nahu02/PhysicalComputing-MainAssignment/Final_Report/figure/agent_pcb_bottom_fusion.png

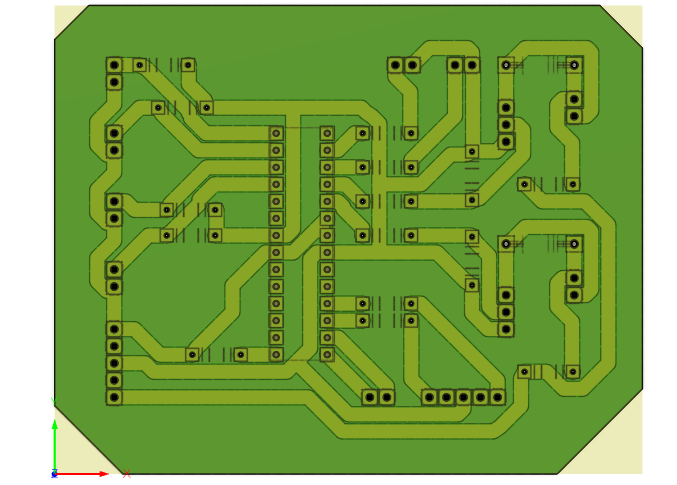
Final_Report/figure/agent_pcb_bottom_fusion.png
