nahu02/PhysicalComputing-MainAssignment/Final_Report/figure/buzzer_mount_angle.jpg

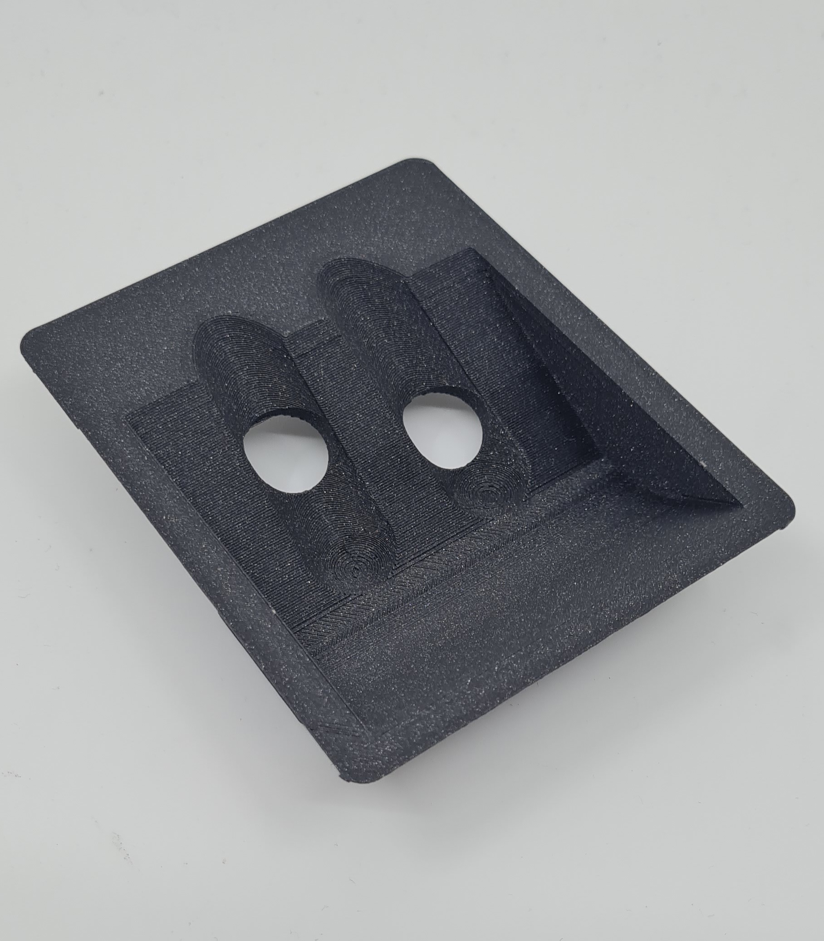
Final_Report/figure/buzzer_mount_angle.jpg
