nahu02/PhysicalComputing-MainAssignment/Final_Report/figure/controller_pcb_bottom_fusion.png

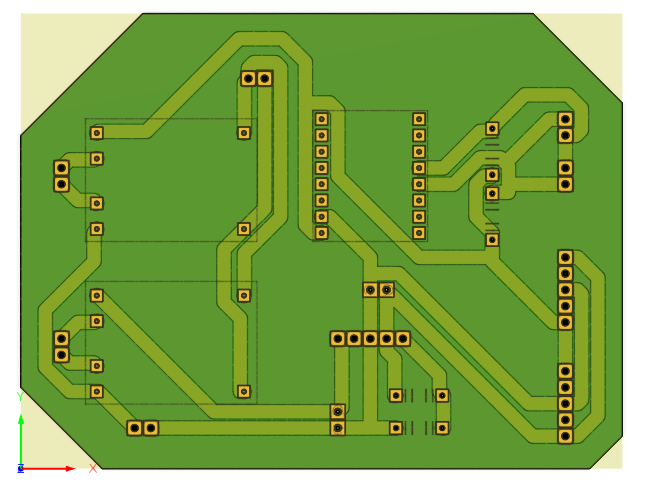
Final_Report/figure/controller_pcb_bottom_fusion.png
