nahu02/PhysicalComputing-MainAssignment/Final_Report/figure/led_keycap_side_v1.jpg

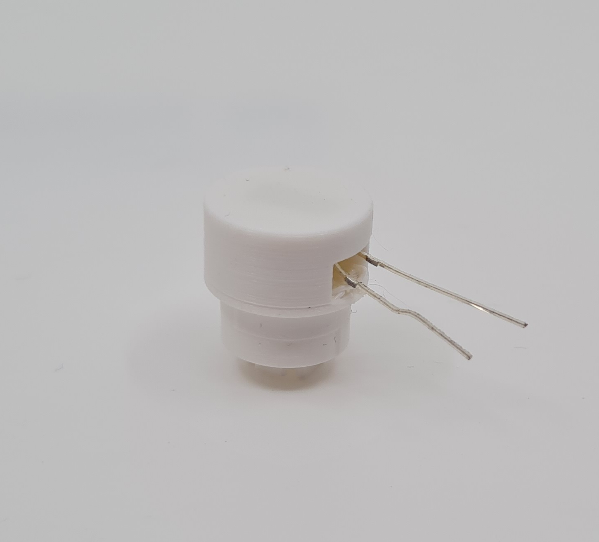
Final_Report/figure/led_keycap_side_v1.jpg
