nahu02/PhysicalComputing-MainAssignment/Final_Report/figure/led_keycap_top_v1.jpg

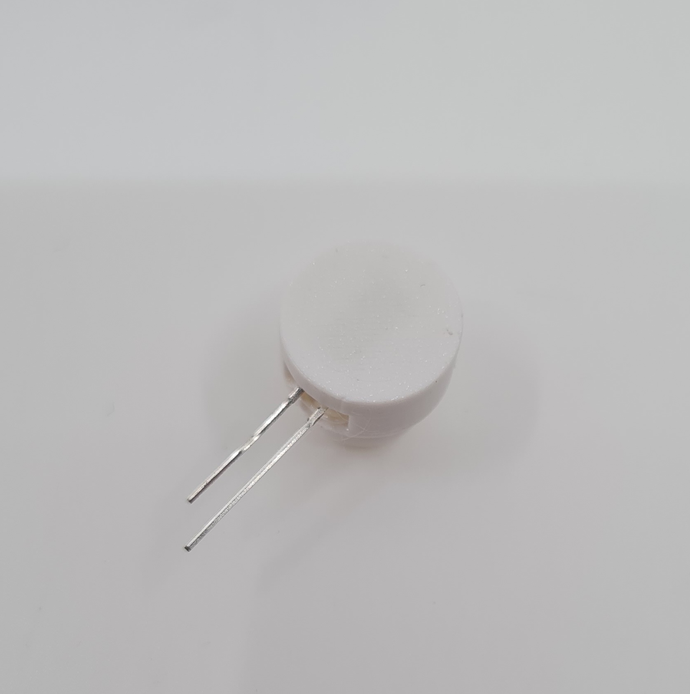
Final_Report/figure/led_keycap_top_v1.jpg
