nahu02/PhysicalComputing-MainAssignment/Final_Report/figure/led_mount_angle.jpg

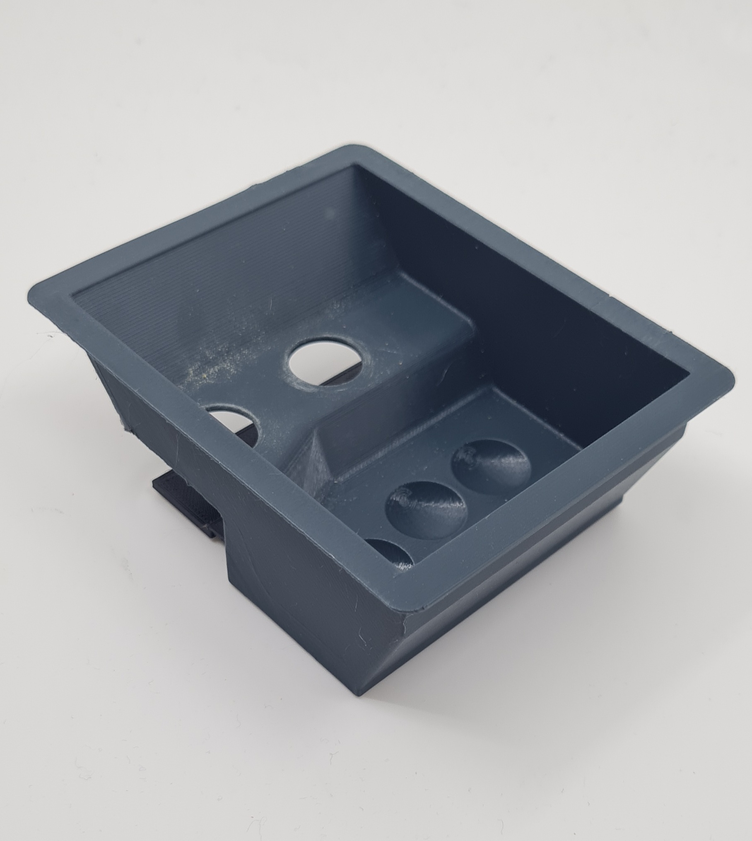
Final_Report/figure/led_mount_angle.jpg
