nahu02/PhysicalComputing-MainAssignment/Final_Report/figure/sample.png

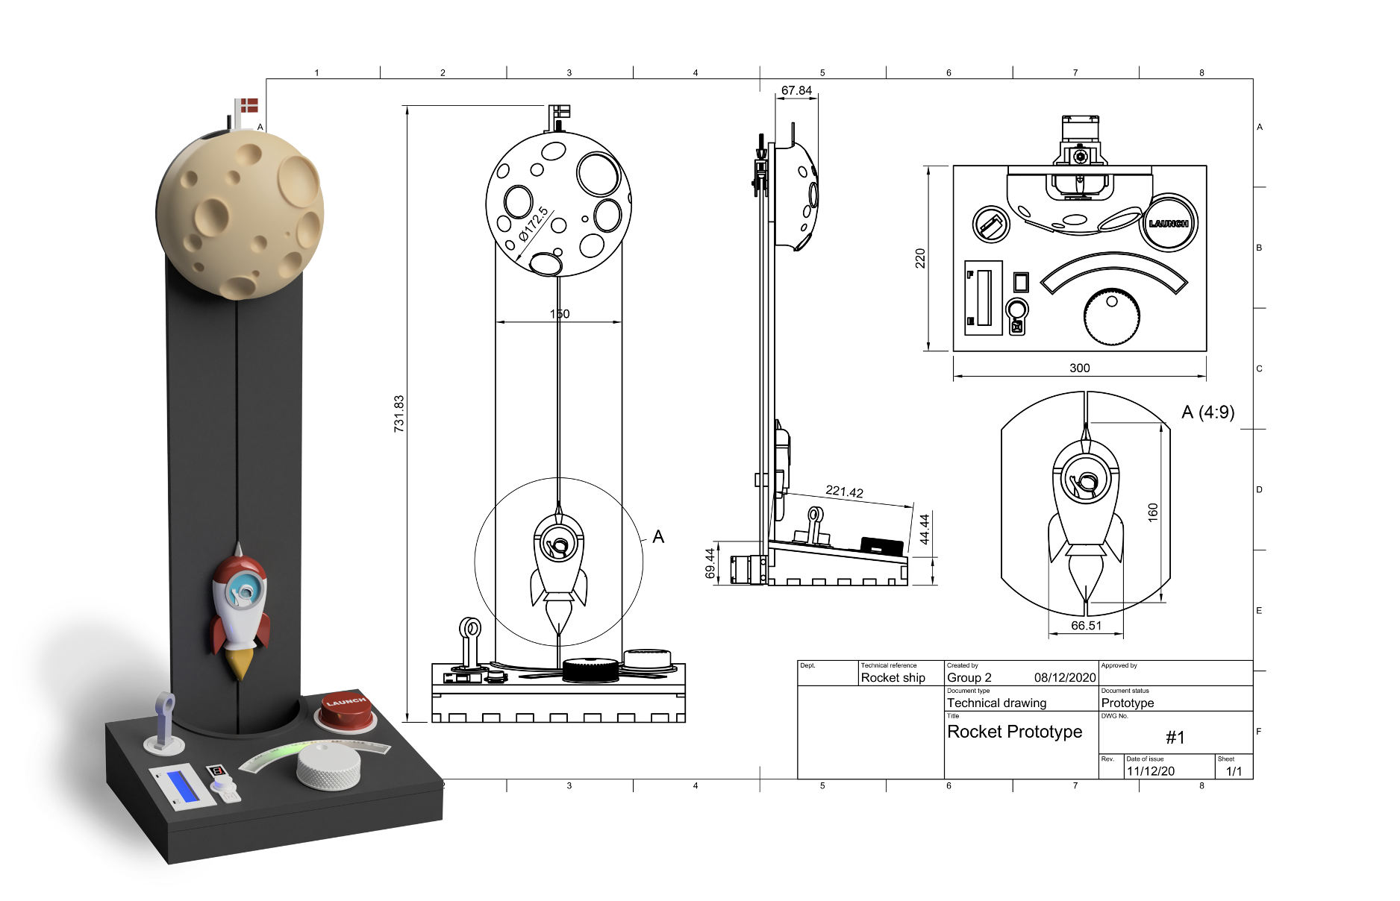
Final_Report/figure/sample.png
