nahu02/PhysicalComputing-MainAssignment/img/circuit_diagram_prototype.pdf

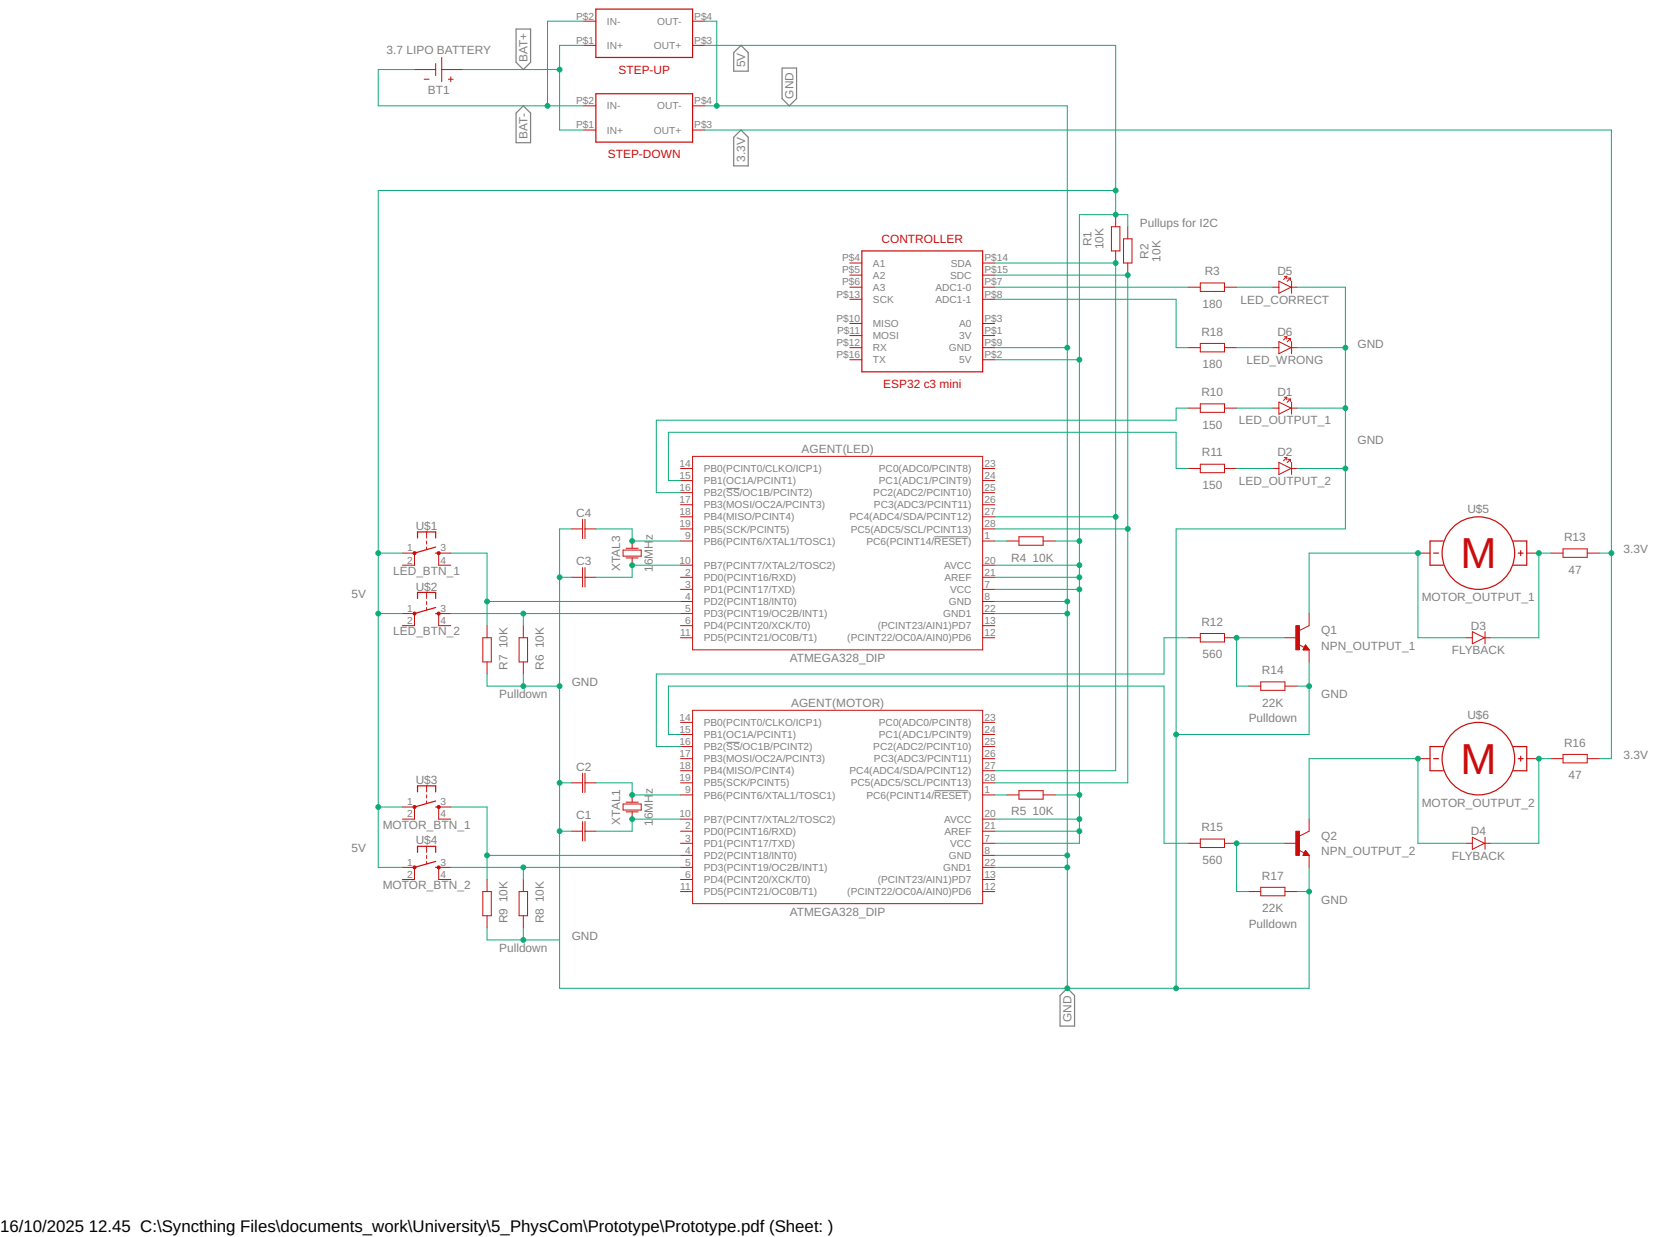
[picture p50: page 1]

16/10/2025 12.45 C:\Syncthing Files\documents_work\University\5_PhysCom\Prototype\Prototype.pdf (Sheet: )
