nahu02/PhysicalComputing-MainAssignment/Final_Report/project_pdfs/controller_board v19.pdf

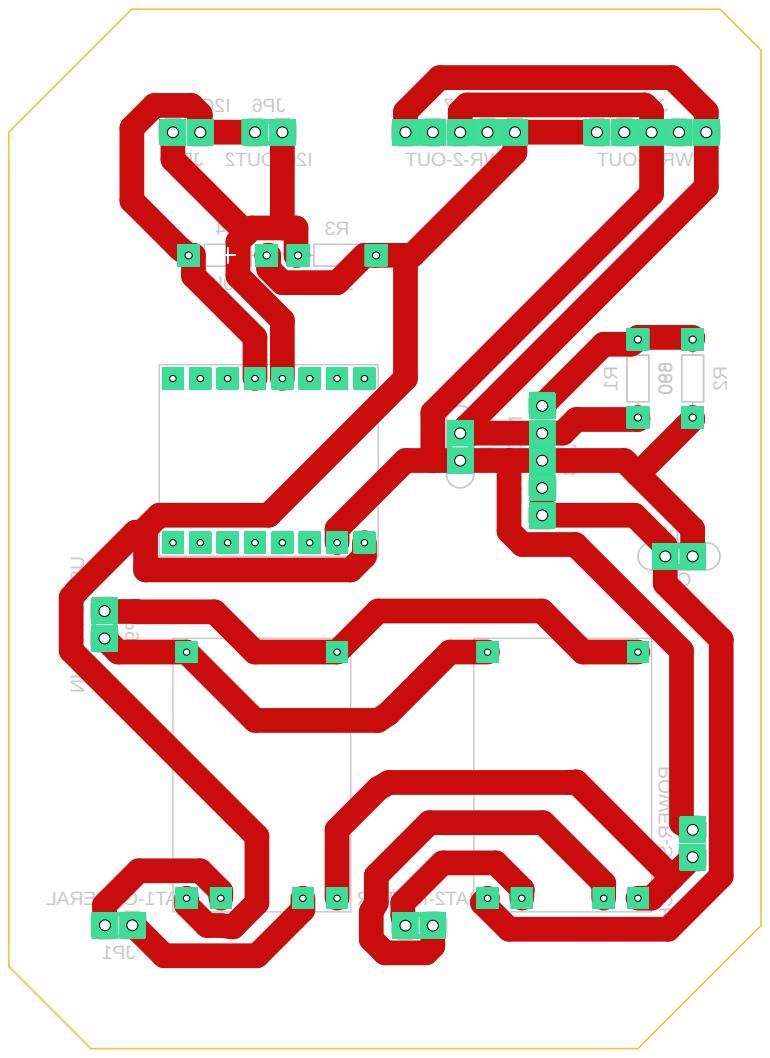
[picture p51: page 1]
