nahu02/PhysicalComputing-MainAssignment/Final_Report/project_pdfs/controller_board_schematic v13.pdf

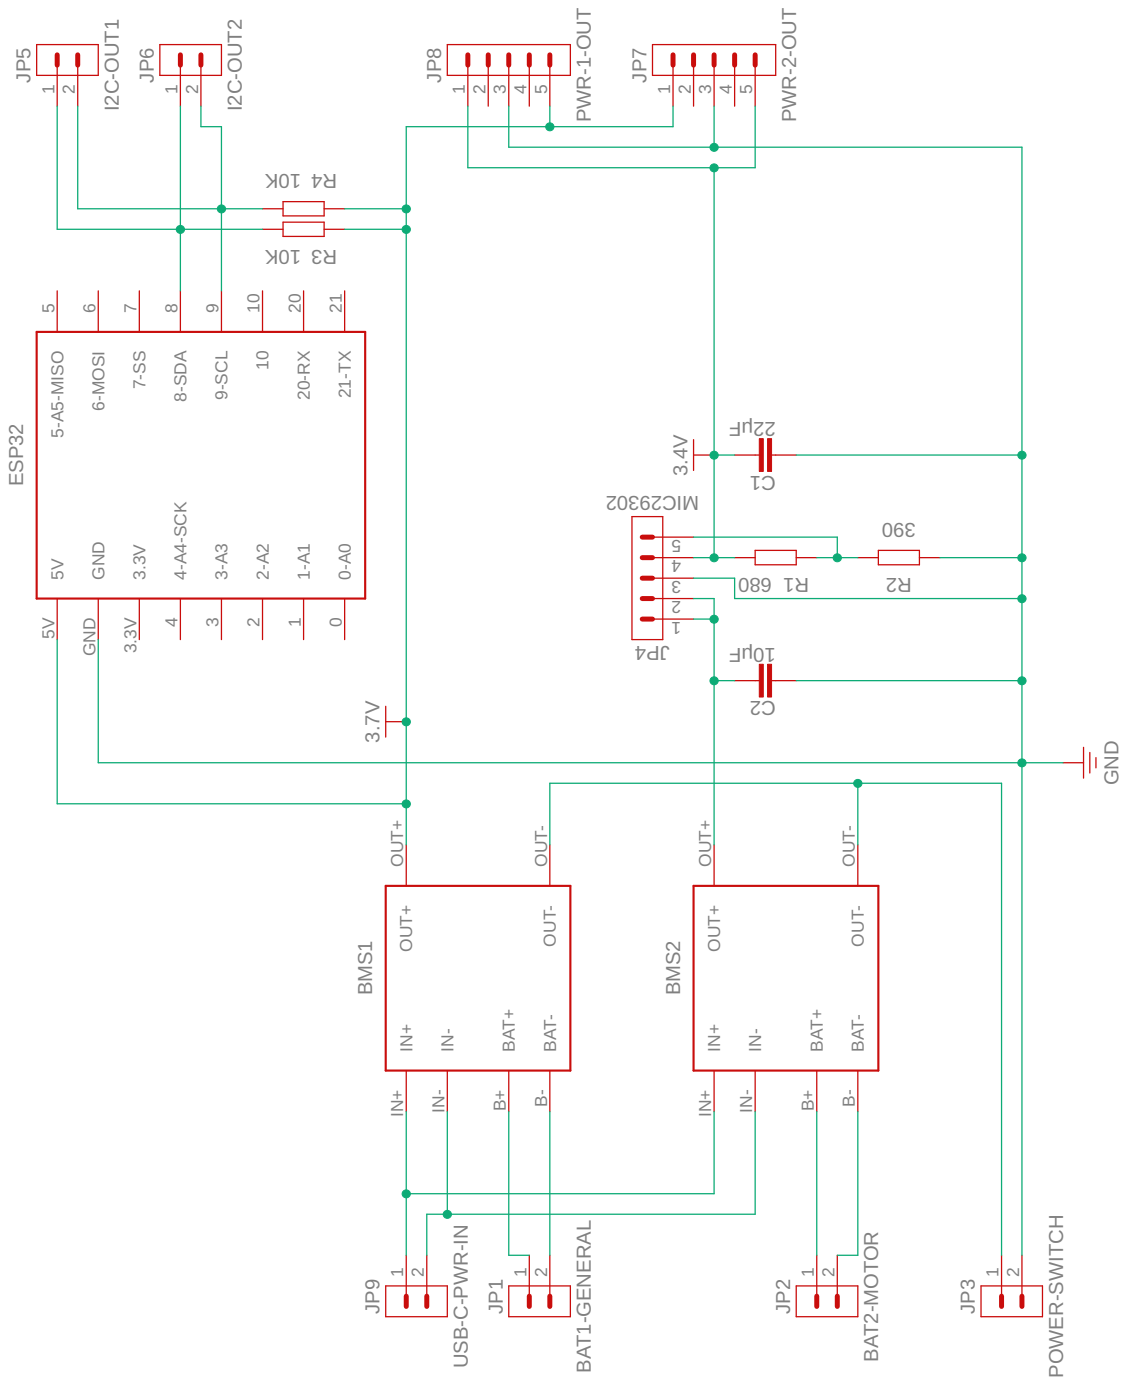
[picture p52: page 1]

2 OUT+ OUT+ OUT- OUT- BAT+ B+ BAT- B-

OUT+ OUT+ OUT- OUT- BAT+ B+ BAT- B-
