nahu02/PhysicalComputing-MainAssignment/img/circuit_diagram_prototype_annotated.pdf

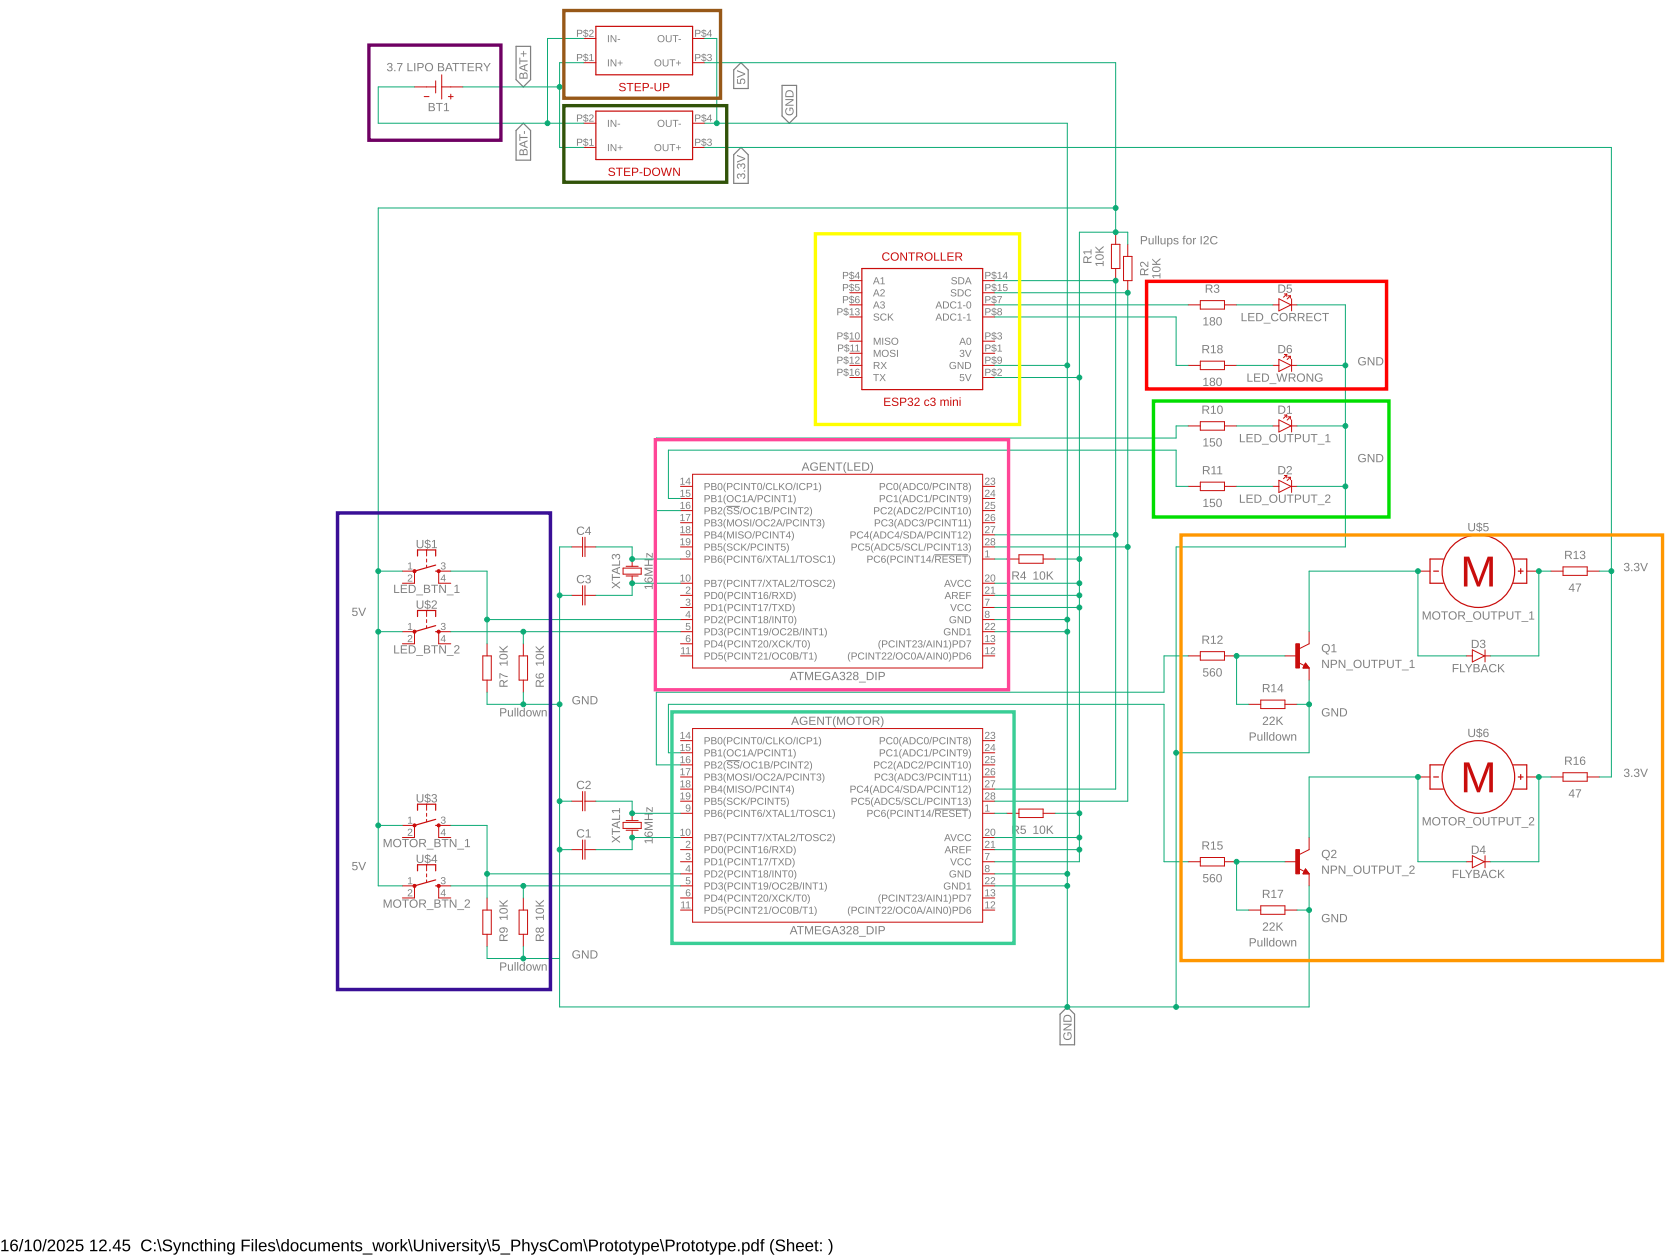
[picture p53: page 1]
