nahu02/PhysicalComputing-MainAssignment/Final_Report/project_pdfs/Agent v8.pdf

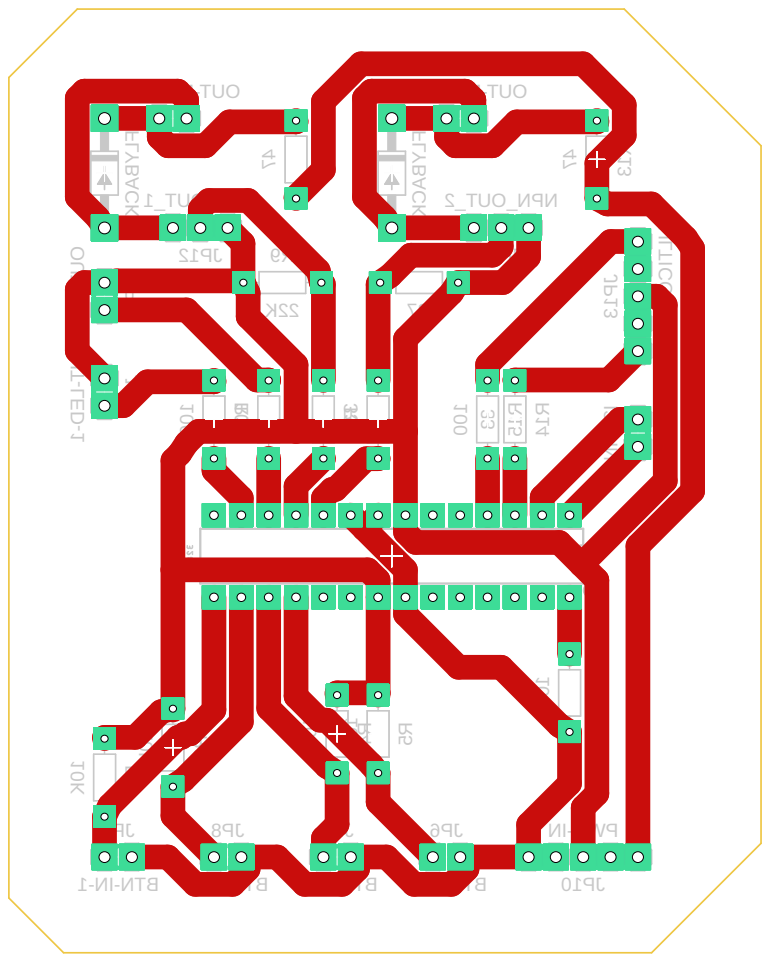
[picture p54: page 1]

D-1 1- NI- NTB 2- NI- NTB 3- NI- NTB 4- NI- NTB
