nahu02/PhysicalComputing-MainAssignment/(commit log)

2025-10-09 agent: enable I2C broadcast listening
2025-10-09 fix agent id to pin mapping
    [agent_buzzer.ino]
2025-10-09 baud and I2C agents and baud update
2025-10-13 agent update: button submit, centralized actuator/button pair handling
2025-10-13 update actuator timing, refactor for loops, use uint8_t instead of byte
2025-10-13 agents button press fix button detection now happens only once, on the rising edge, when the button is pressed down
    [agent_buzzer.ino, agent_led.ino]
2025-10-13 better I2C agent availability check
2025-10-16 add blinking LEDs for success/failure status indication
    [Main.ino]
2025-10-16 setup status indication leds
2025-10-16 Swap LED loss/win output
    [Main.ino]
2025-10-17 finish prototype description
2025-11-06 change actuator/button pairs number to 4 for each agent
2025-11-06 change global number of actuators to 8
2025-11-25 enclosure box sketch
2025-11-27 update actuator/button pin assignments for agents
2025-11-27 Update node array to include status LEDs
2025-11-27 Updated comments and added if check for non-existing buttons in agent loop
2025-11-27 Main: feedback LED update
2025-11-30 Added schematics and pcbs to appendix
2025-11-30 Add web debugging - updated readme - made macro to switch it off
2025-11-30 we're dumb and chatgpt is smart fixed shared code not letting the feedback LEDs turn on - ever
    [shared.h]
2025-12-01 Update actuator/button pairs for best wiring
2025-12-01 add screenshots of fusion pcbs and models and append pcb pics to report
2025-12-03 design prototype 3D-models and box
2025-12-03 Added power usage and introduction section
2025-12-03 format pics and add buttons pics
2025-12-04 quickfix: debounce logic to handle double press issues
    [Main.ino]
2025-12-05 assembly and pictures
